Eymeric65/CO2_Portable_sensor_main/PCB/CO2_sensor/Illustration/Front.png

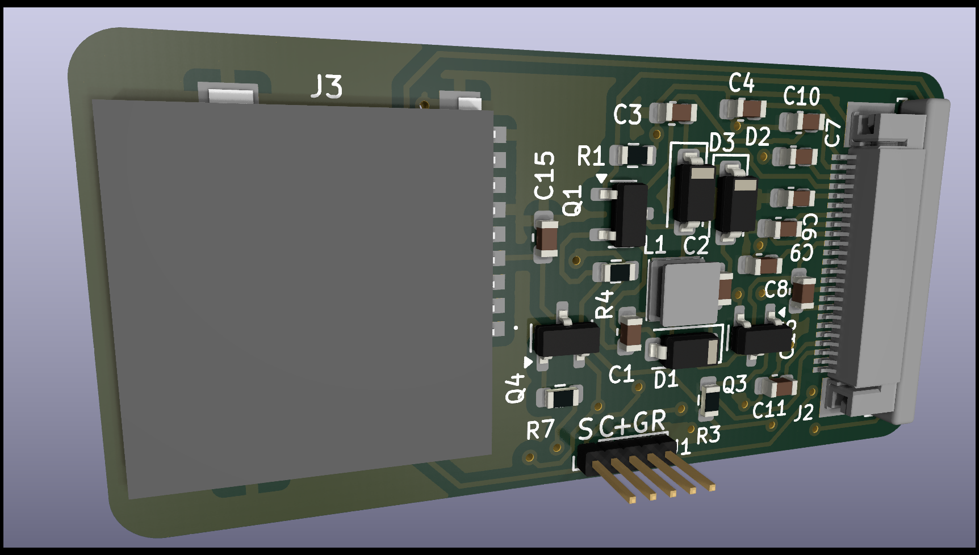
PCB/CO2_sensor/Illustration/Front.png
