Eymeric65/CO2_Portable_sensor_main/PCB/CO2_sensor/Illustration/Back.png

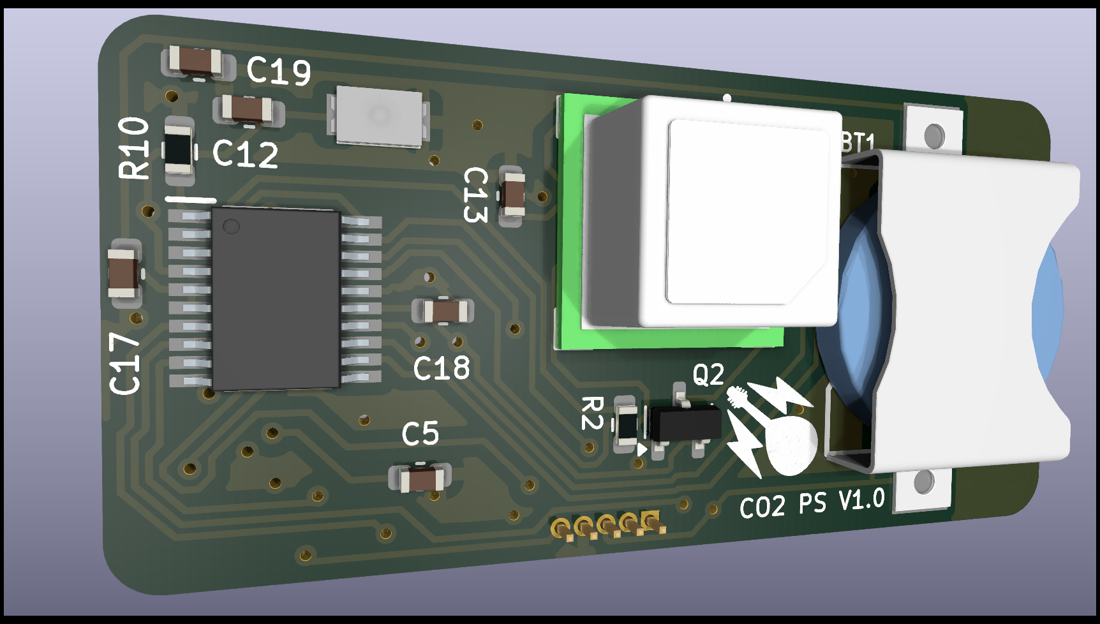
PCB/CO2_sensor/Illustration/Back.png
