Eymeric65/CO2_Portable_sensor_main/PCB/CO2_sensor/Silk/.svg2shenzhen-cache/images/F.SilkS_g2.png

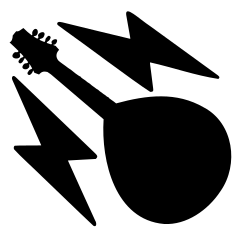
PCB/CO2_sensor/Silk/.svg2shenzhen-cache/images/F.SilkS_g2.png
