Eymeric65/CO2_Portable_sensor_main/case/3D_print/Bottom part.stp

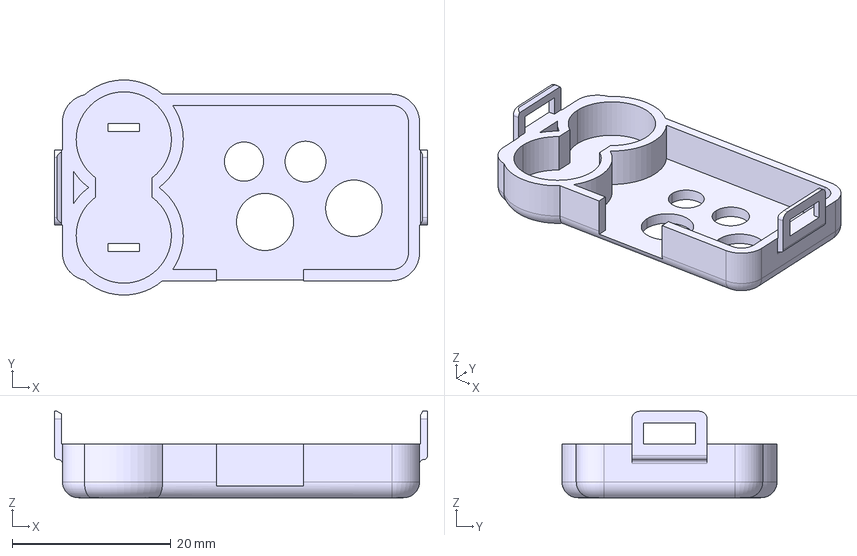
[picture p6: CAD file, 2024-08-28]
case/3D_print/Bottom part.stp
47.0 x 27.1 x 10.9 mm
