Eymeric65/CO2_Portable_sensor_main/case/CO2_sensor.step

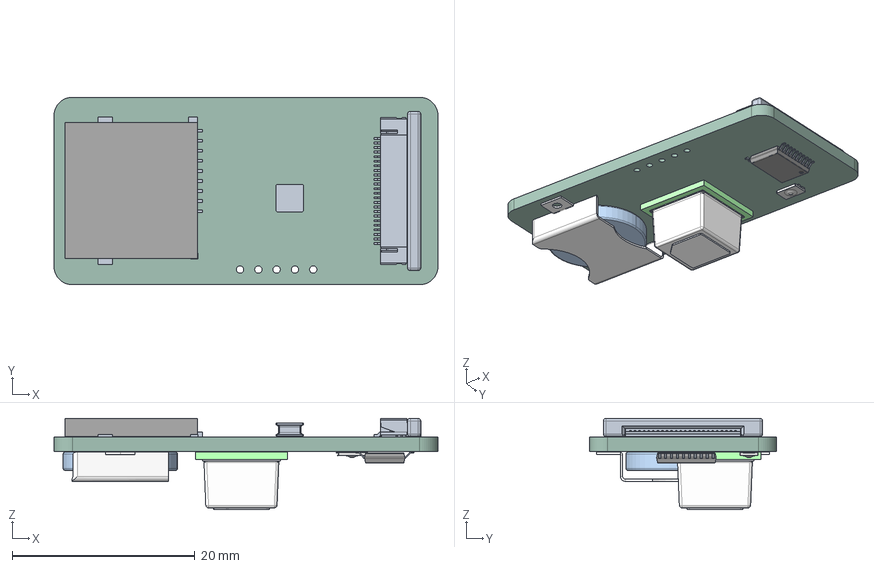
[picture p7: CAD file, 2024-08-28]
case/CO2_sensor.step
42.0 x 20.5 x 10.0 mm
C-2-1734592-4
MSD-1-A
SRN3015
SCD40-D-R2
ASSEMBLY
P:\E-Switch Secure\3D_MODELS_STP_FORMAT\TL3780AFxxxQG.stp
SMTM1225
CO2_sensor_PCB
