Eymeric65/CO2_Portable_sensor_main/PCB/CO2_sensor/STEP/SMTM1225.stp

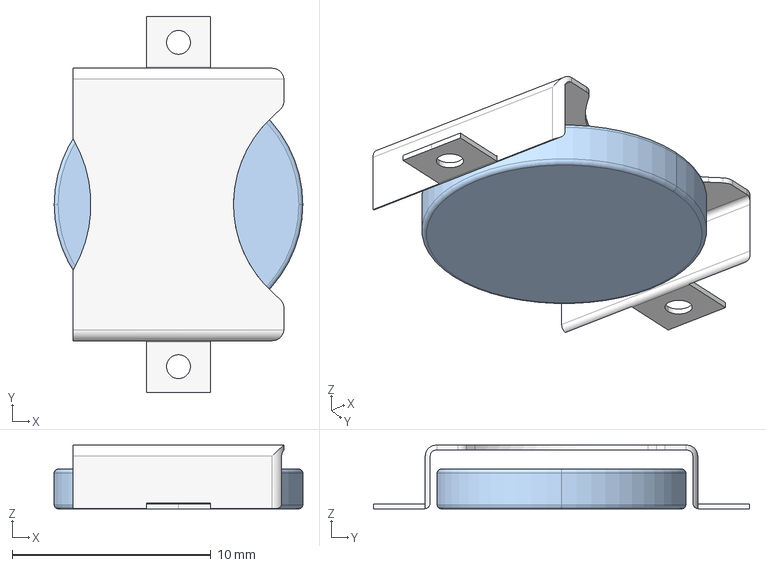
[picture p8: CAD file, 2024-08-28]
PCB/CO2_sensor/STEP/SMTM1225.stp
12.5 x 18.9 x 3.20 mm
Pile
