Eymeric65/CO2_Portable_sensor_main/PCB/Kicad_lib/STEP/FH12-24S-0.5SH.stp

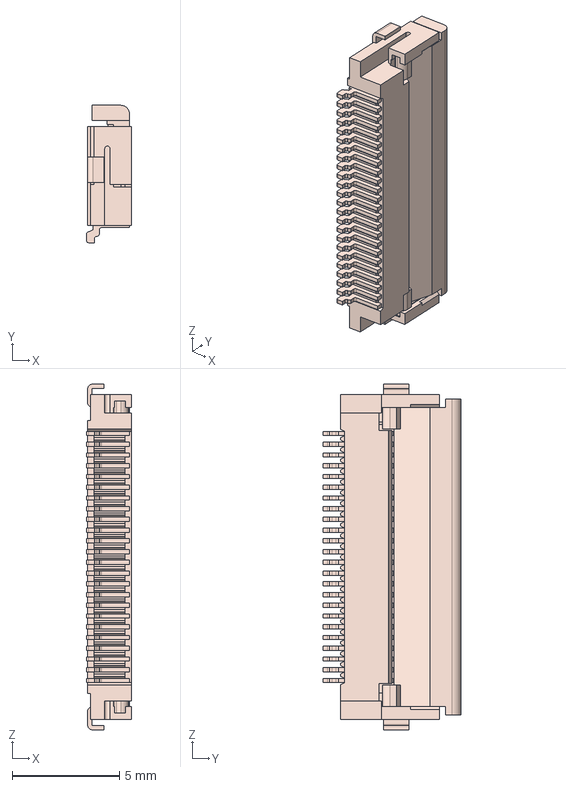
[picture p9: CAD file, 2024-08-28]
PCB/Kicad_lib/STEP/FH12-24S-0.5SH.stp
2.10 x 6.40 x 16.1 mm
