Eymeric65/CO2_Portable_sensor_main/PCB/Kicad_lib/STM32L031F6P7/3D/STM32L031F6P7.stp

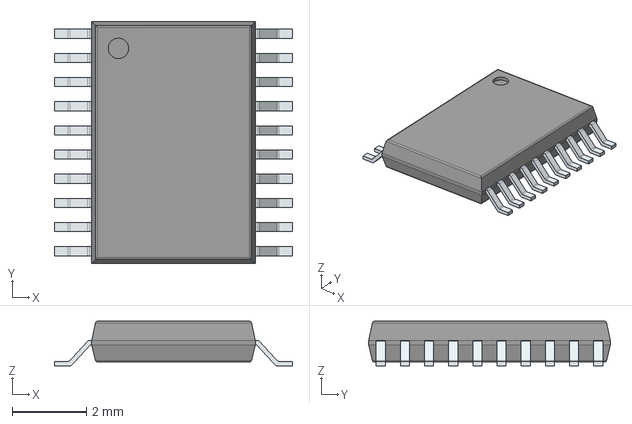
[picture p10: CAD file, 2024-08-28]
PCB/Kicad_lib/STM32L031F6P7/3D/STM32L031F6P7.stp
6.40 x 6.50 x 1.20 mm
PinsArrayLR
