Eymeric65/CO2_Portable_sensor_main/case/3D_print/Top Part.stp

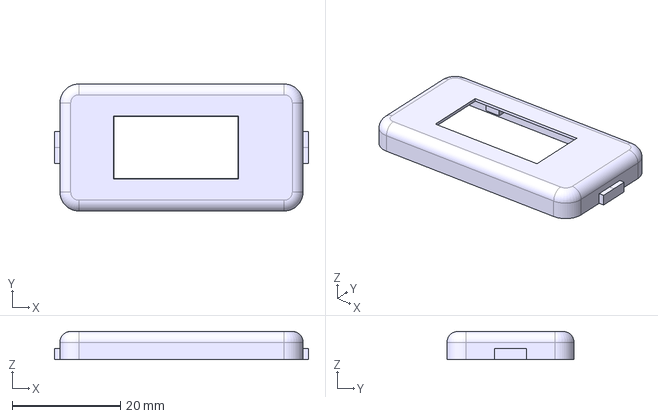
[picture p11: CAD file, 2024-08-28]
case/3D_print/Top Part.stp
47.0 x 23.5 x 5.20 mm
