Eymeric65/CO2_Portable_sensor_main/PCB/Kicad_lib/STEP/TL3780AF240QG.stp

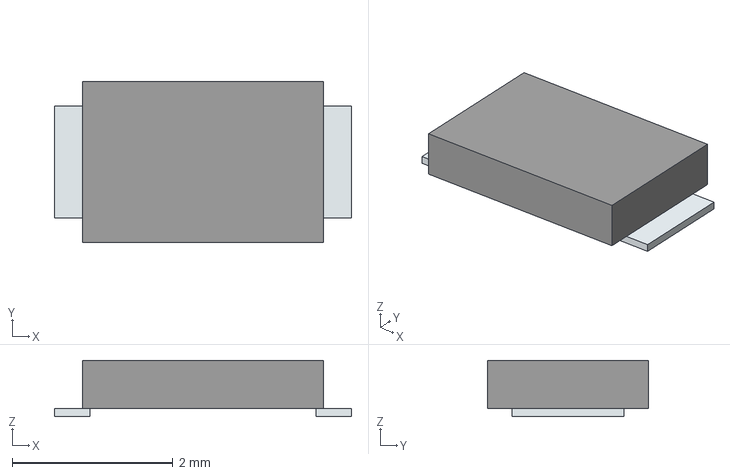
[picture p12: CAD file, 2024-08-28]
PCB/Kicad_lib/STEP/TL3780AF240QG.stp
3.69 x 2.00 x 0.7 mm
Pins
