Eymeric65/CO2_Portable_sensor_main/PCB/STEP manquant/MSD-1-A.stp

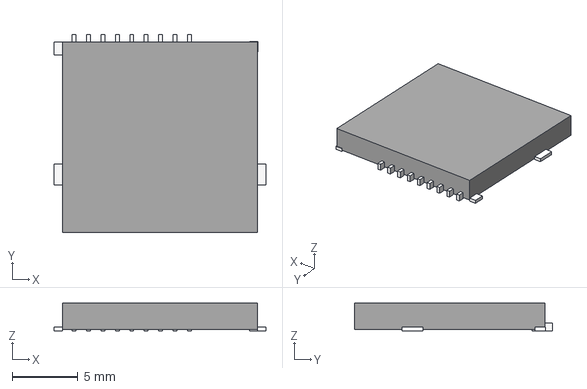
[picture p13: CAD file, 2024-08-28]
PCB/STEP manquant/MSD-1-A.stp
16.1 x 15.1 x 2.10 mm
GND Plate
