Eymeric65/CO2_Portable_sensor_main/PCB/CO2_sensor/STEP/SRN3015-100M.stp

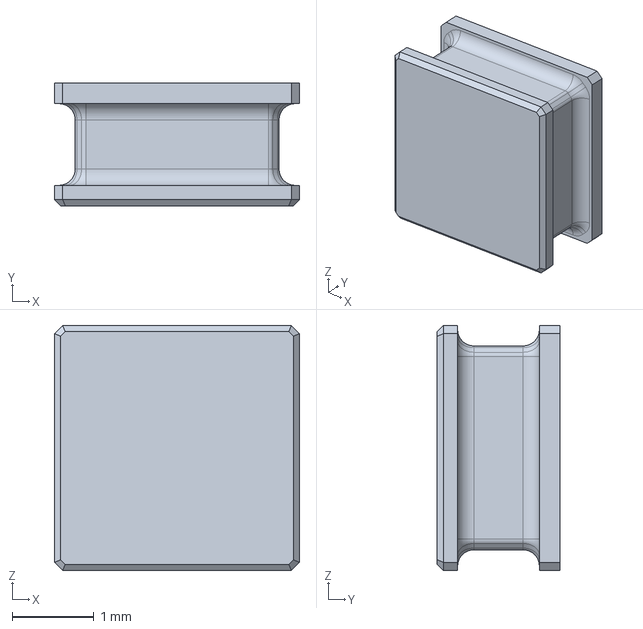
[picture p14: CAD file, 2024-08-28]
PCB/CO2_sensor/STEP/SRN3015-100M.stp
3.00 x 1.50 x 3.00 mm
