Eymeric65/CO2_Portable_sensor_main/PCB/CO2_sensor/STEP/SCD40-D-R2.stp

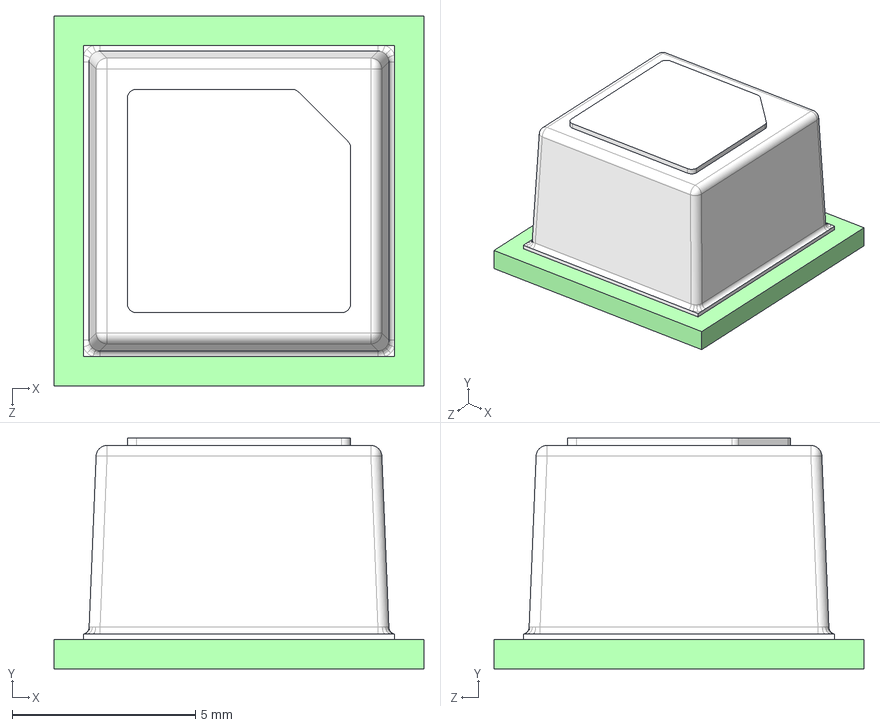
[picture p15: CAD file, 2024-08-28]
PCB/CO2_sensor/STEP/SCD40-D-R2.stp
10.1 x 6.30 x 10.1 mm
