Eymeric65/CO2_Portable_sensor_main/PCB/CO2_sensor/STEP/TL3780AF240QG.stp

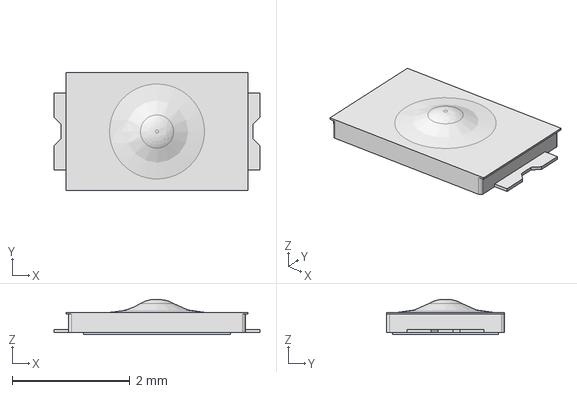
[picture p16: CAD file, 2024-08-28]
PCB/CO2_sensor/STEP/TL3780AF240QG.stp
3.50 x 2.00 x 0.6 mm
