Eymeric65/CO2_Portable_sensor_main/(list of files, cad)

Other CAD files:
PCB/STEP manquant/Body.CATPart
PCB/STEP manquant/GND Plate.CATPart
PCB/STEP manquant/MSD-1-A.CATPart
PCB/STEP manquant/MSD-1-A.CATProduct
PCB/STEP manquant/Pile.CATPart
PCB/STEP manquant/SMTM1225.CATProduct
case/Bottom part.CATPart
case/CO2 probe.CATProduct
case/CO2_sensor PCB.CATPart
case/CO2_sensor.CATProduct
case/COMPOUND.CATPart
case/COMPOUND_1.CATPart
case/LR44.CATPart
case/Part1.CATPart
case/SOLID.CATPart
case/SOLID_1.CATPart
case/SOLID_2.CATPart
case/SOLID_3.CATPart
case/Screen.CATPart
case/Top Part.CATPart
case/Top Part.stp
