Eymeric65/CO2_Portable_sensor_main/PCB/CO2_sensor/CO2_sensor.kicad_pcb

## KiCad design PCB/CO2_sensor/CO2_sensor.kicad_pcb (2024-08-28)

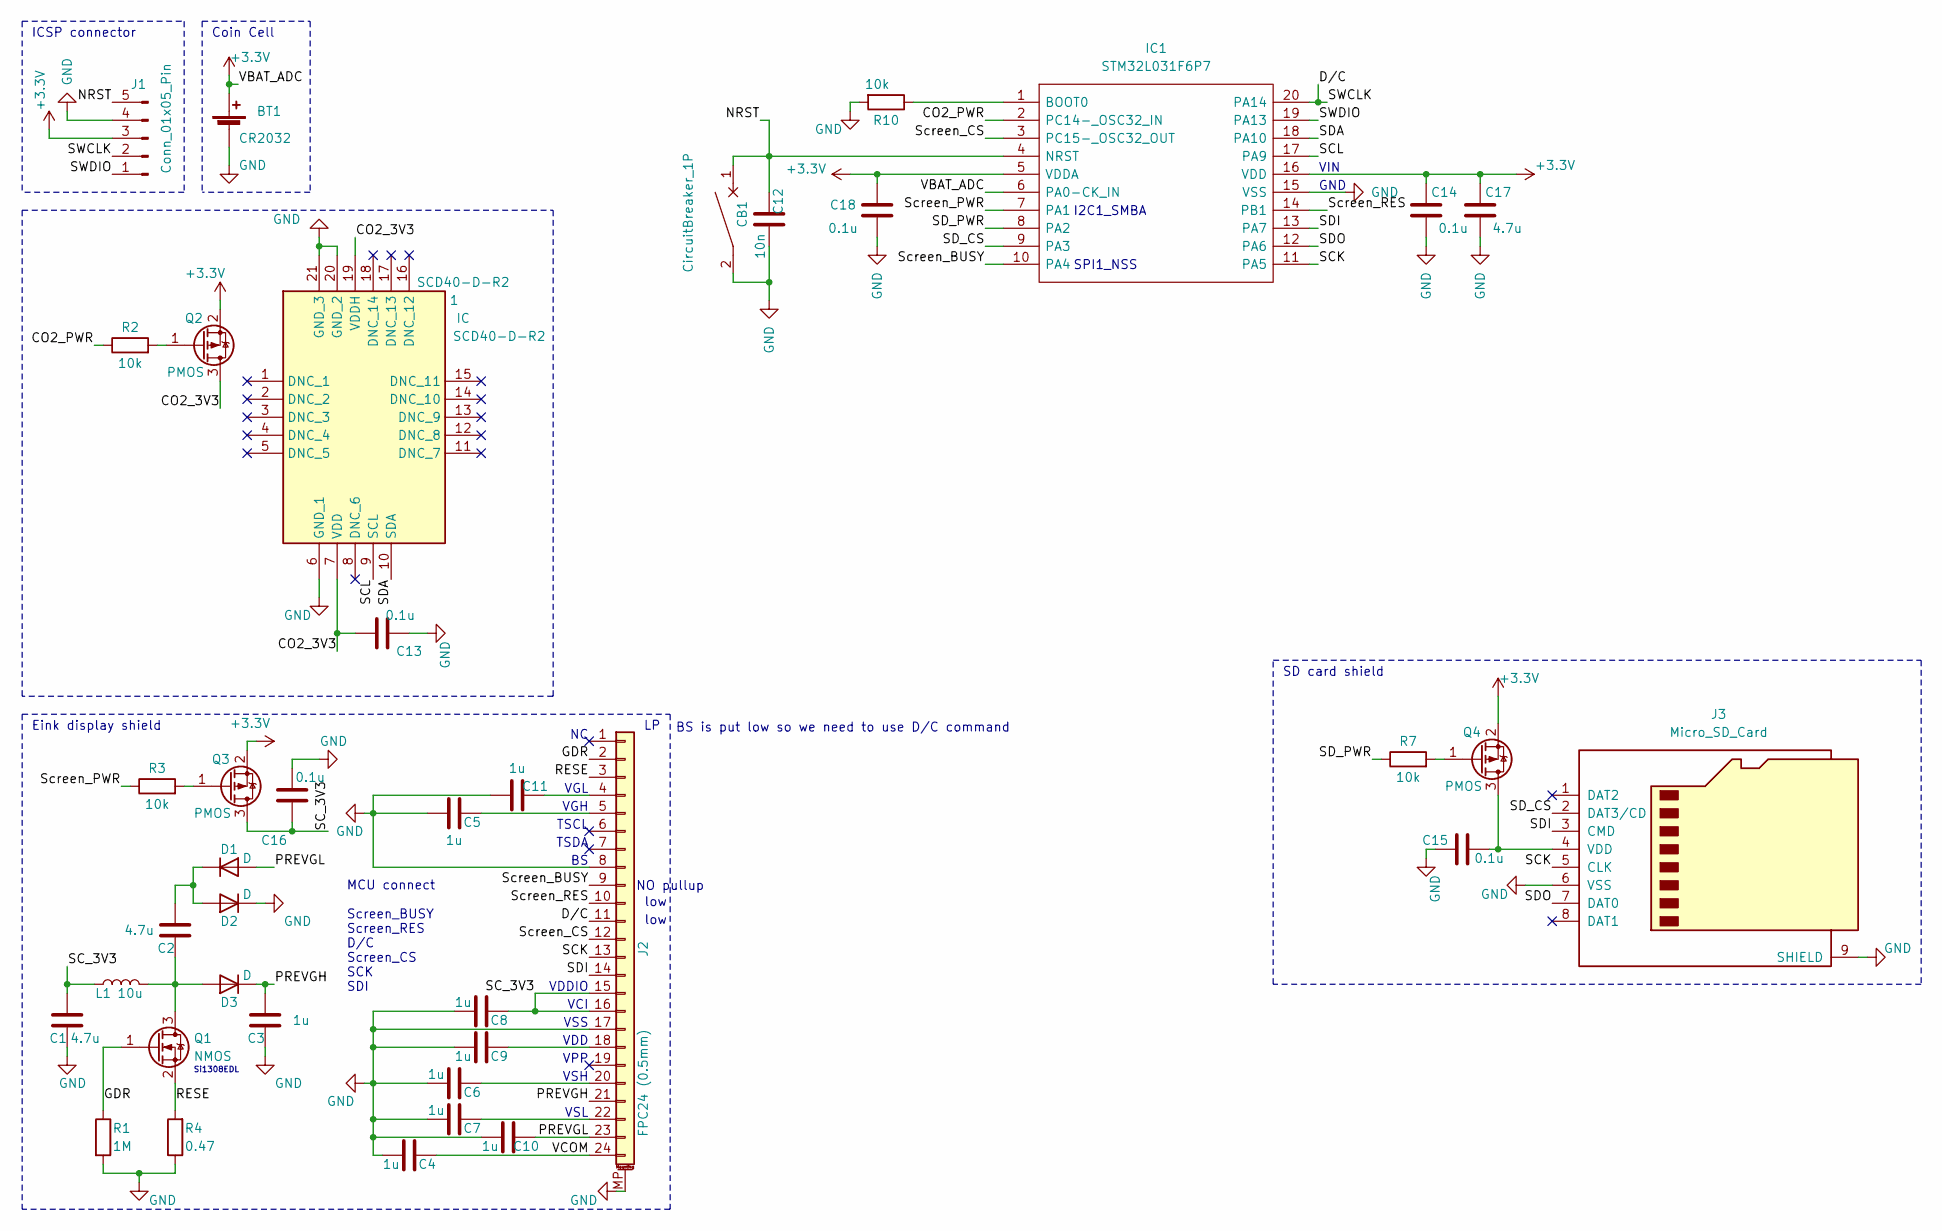
[picture p17: schematic CO2_sensor.kicad_sch]

Parts:
1: SCD40-D-R2; SCD40DR2; Manufacturer_Part_Number SCD40-D-R2; Mouser Part Number 403-SCD40-D-R2
BT1: CR2032; SMTM1225
C1, C2, C17: 4.7u; C_0603_1608Metric
C3, C4, C5, C6, C7, C8, C9, C10, C11: 1u; C_0603_1608Metric
C12: 10n; C_0603_1608Metric
C13, C14, C15, C16, C18: 0.1u; C_0603_1608Metric
CB1: CircuitBreaker_1P; TL3780AF240QG
D1, D2, D3: D; D_SOD-123
IC1: STM32L031F6P7; SOP65P640X120-20N; Mouser Part Number 511-STM32L031F6P7
J1: Conn_01x05_Pin; PinHeader_1x05_P2.00mm_Vertical
J2: FPC24 (0.5mm); TE_2-1734839-4_1x24-1MP_P0.5mm_Horizontal
J3: Micro_SD_Card; MSD1A
L1: 10u; SRN3015
Q1: NMOS; SOT-23
Q2, Q3, Q4: PMOS; SOT-23
R1: 1M; R_0603_1608Metric
R2, R3, R7, R10: 10k; R_0603_1608Metric
R4: 0.47; R_0603_1608Metric

Connections:
+3.3V: BT1.1 (+), C14.2, C17.2, C18.2, IC1.5 (VDDA), IC1.6 (PA0-CK_IN), IC1.16 (VDD), J1.3, Q2.2 (S), Q3.2 (S), Q4.2 (S)
/CO2_3V3: 1.7 (VDD), 1.19 (VDDH), C13.1, Q2.3 (D)
/CO2_PWR: IC1.2 (PC14-_OSC32_IN), R2.1
/D/C: IC1.20 (PA14), J1.2, J2.11
/GDR: J2.2, Q1.1 (G), R1.1
/NRST: C12.2, CB1.1, IC1.4 (NRST), J1.5
/PREVGH: C3.1, D3.1 (K), J2.21
/PREVGL: C10.2, D1.2 (A), J2.23
/RESE: J2.3, Q1.2 (S), R4.2
/SCK: IC1.11 (PA5), J2.13, J3.5 (CLK)
/SCL: 1.9 (SCL), IC1.17 (PA9)
/SC_3V3: C1.1, C8.2, C16.2, J2.15, J2.16, L1.1, Q3.3 (D)
/SDA: 1.10 (SDA), IC1.18 (PA10)
/SDI: IC1.13 (PA7), J2.14, J3.3 (CMD)
/SDO: IC1.12 (PA6), J3.7 (DAT0)
/SD_CS: IC1.9 (PA3), J3.2 (DAT3/CD)
/SD_PWR: IC1.8 (PA2), R7.1
/SWDIO: IC1.19 (PA13), J1.1
/Screen_BUSY: IC1.10 (PA4), J2.9
/Screen_CS: IC1.3 (PC15-_OSC32_OUT), J2.12
/Screen_PWR: IC1.7 (PA1), R3.1
/Screen_RES: IC1.14 (PB1), J2.10
/VCOM: C4.2, J2.24
GND: 1.6 (GND_1), 1.20 (GND_2), 1.21 (GND_3), BT1.2 (-), C1.2, C3.2, C4.1, C5.1, C6.1, C7.1, C8.1, C9.1, C10.1, C11.1, C12.1, C13.2, C14.1, C15.2, C16.1, C17.1, C18.1, CB1.2, D2.1 (K), IC1.15 (VSS), J1.4, J2.8, J2.17, J2.MP (MountPin), J3.6 (VSS), J3.9 (SHIELD), R1.2, R4.1, R10.2
unnamed: C2.1, D1.1 (K), D2.2 (A)
unnamed: C2.2, D3.2 (A), L1.2, Q1.3 (D)
unnamed: IC1.1 (BOOT0), R10.1
unnamed: C11.2, J2.4
unnamed: C5.2, J2.5
unnamed: C9.2, J2.18
unnamed: C6.2, J2.20
unnamed: C7.2, J2.22
unnamed: C15.1, J3.4 (VDD), Q4.3 (D)
unnamed: Q2.1 (G), R2.2
unnamed: Q3.1 (G), R3.2
unnamed: Q4.1 (G), R7.2

Notes on the sheet:
SD card shield
Si1308EDL
ICSP connector
VGH
SPI1_NSS
VSS
TSDA
VDD
BS is put low so we need to use D/C command
NO pullup
MCU connect Screen_BUSY Screen_RES D/C Screen_CS SCK SDI
TSCL
VPP
VIN
GND
low
VDDIO
VGL
Coin Cell
VCI
Eink display shield
VSH
I2C1_SMBA
VSL

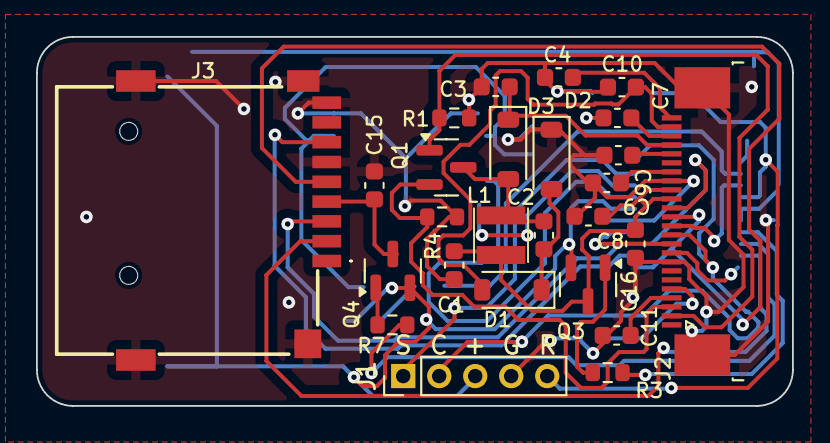
[picture p18: board CO2_sensor.kicad_pcb from above]

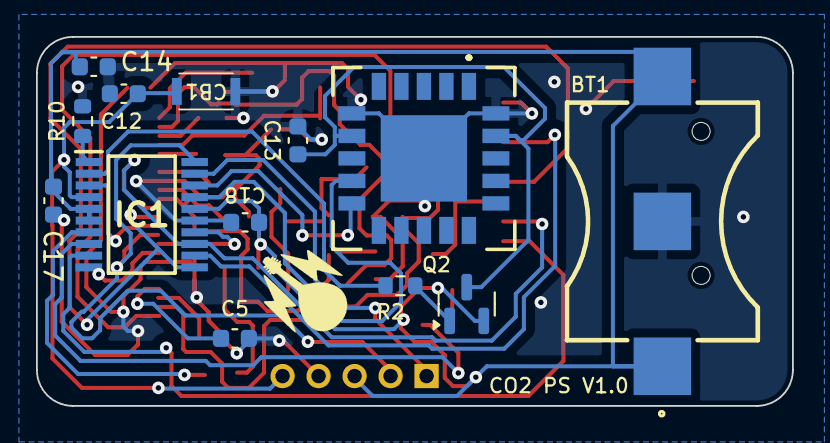
[picture p19: board CO2_sensor.kicad_pcb from below]

Board: 2 copper layers, 42.0 x 20.5 mm, 40 parts (14 on the bottom side), 36 nets.

Other parts of the board:
Ref**: Val**; drawing
