Eymeric65/CO2_Portable_sensor_main/Sonde_CO2/Core/Src/main.c

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
/* Includes ------------------------------------------------------------------*/
#include "main.h"

I2C_HandleTypeDef hi2c1;

RTC_HandleTypeDef hrtc;

SPI_HandleTypeDef hspi1;

void SystemClock_Config(void);
static void MX_GPIO_Init(void);
static void MX_I2C1_Init(void);
static void MX_SPI1_Init(void);
static void MX_RTC_Init(void);
/**
  * @brief  The application entry point.
  * @retval int
  */
int main(void)
{

  /* MCU Configuration--------------------------------------------------------*/

  /* Reset of all peripherals, Initializes the Flash interface and the Systick. */
  HAL_Init();

  /* Configure the system clock */
  SystemClock_Config();

  /* Initialize all configured peripherals */
  MX_GPIO_Init();
  MX_I2C1_Init();
  MX_SPI1_Init();
  MX_RTC_Init();
  /* USER CODE BEGIN 2 */
  SCREEN_GPIO_Deact();

  uint8_t DrawMap[EPD_ARRAY];

  //memset(DrawMap,0xFF,sizeof(DrawMap));
  memcpy(DrawMap,Base_map,sizeof(Base_map));

  //HAL_GPIO_WritePin(GPIOC, CO2_PWR_Pin, GPIO_PIN_SET);


    SCREEN_GPIO_Act();

    HAL_Delay(1000);

	EPD_Init(); //Full screen refresh initialization.
	EPD_WhiteScreen_ALL(DrawMap); //To Display one image using full screen refresh.
	EPD_DeepSleep(); //Enter the sleep mode and please do not delete it, otherwise it will reduce the lifespan of the screen.

	SCREEN_GPIO_Deact();

	HAL_Delay(1000);

  /* USER CODE END 2 */

  /* Infinite loop */
  /* USER CODE BEGIN WHILE */
	unsigned int t = 0;

  while (1)
  {

		//UNCOMMENT THIS

		uint8_t response[9];
		HAL_GPIO_WritePin(GPIOC, CO2_PWR_Pin, GPIO_PIN_RESET); // pin power
		HAL_Delay(100);

		while(Send_I2C_Command(&hi2c1, SCD_ADDRESS, (uint16_t ) 0x21b1, 20)!= HAL_OK){HAL_Delay(50);};

		HAL_StatusTypeDef ans1 = HAL_ERROR;

		while( ans1 == HAL_ERROR)
		{
			Send_I2C_Command(&hi2c1, SCD_ADDRESS, (uint16_t ) 0xec05, 20);

			HAL_Delay(1);

			ans1 = HAL_I2C_Master_Receive(&hi2c1,SCD_ADDRESS, (uint8_t *) response,9, 20);
			HAL_Delay(50);
		}

		Send_I2C_Command(&hi2c1, SCD_ADDRESS, (uint16_t ) 0x3f86, 20);

		HAL_GPIO_WritePin(GPIOC, CO2_PWR_Pin, GPIO_PIN_SET); // pin power
//		//
//		//
//		//
//		//
		uint16_t CO2 = (response[0] << 8) | response[1];

		float T =  (response[3] << 8) | response[4];

		T = -45 + 175*T/65536;

		float H =  (response[6] << 8) | response[7];

		H = 100*H/65536;

		SCREEN_GPIO_Act();

		HAL_Delay(250);

		t = t+2;

		Display_Text(Zone_Write_nums(64,17,FONT_INFO,(int) T,0,0,4),DrawMap,Base_map );
		Display_Text(Zone_Write_nums(34,65,FONT_CO2,CO2,0,1,5),DrawMap,Base_map);
		Display_Text(Zone_Write_nums(20,17,FONT_INFO,(int) H,0,0,4),DrawMap,Base_map );

		Display_Text(Zone_Write_nums(118,83,FONT_TIME,t/60,0,0,5),DrawMap,Base_map ); //Heure
		Display_Text(Zone_Write_nums(81,83,FONT_TIME,t%60,0,0,2),DrawMap,Base_map ); //Minutes

		EPD_DeepSleep();
//
//


//
//		//--------------------------------------
//
	  HAL_GPIO_WritePin(GPIOC, CO2_PWR_Pin, GPIO_PIN_SET);
	  SCREEN_GPIO_Deact();

		HAL_SuspendTick();
		HAL_RTCEx_SetWakeUpTimer_IT(&hrtc, 600, RTC_WAKEUPCLOCK_CK_SPRE_16BITS);

		/* Enter STOP 2 mode */
		HAL_PWR_EnterSTOPMode(PWR_LOWPOWERREGULATOR_ON,  PWR_STOPENTRY_WFI);
		//HAL_PWR_EnterSTOPMode(PWR_MAINREGULATOR_ON,  PWR_STOPENTRY_WFI);


		//HAL_PWREx_EnterSTOP2Mode(PWR_STOPENTRY_WFI);
		HAL_RTCEx_DeactivateWakeUpTimer(&hrtc);
		SystemClock_Config();
		HAL_ResumeTick();


    /* USER CODE END WHILE */

    /* USER CODE BEGIN 3 */
  }
  /* USER CODE END 3 */
}

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
