Eymeric65/CO2_Portable_sensor_main/Sonde_CO2/Sonde_CO2.ioc

Mcu.UserName=STM32L031F6Px
PA1.GPIO_Label=Screen_PWR
PA1.Signal=GPIO_Output
PA10.Signal=I2C1_SDA
PA14.GPIO_Label=D_C
PA14.Signal=GPIO_Output
PA2.GPIO_Label=SD_PWR
PA2.Signal=GPIO_Output
PA3.GPIO_Label=SD_CS
PA3.Signal=GPIO_Output
PA4.GPIO_Label=Screen_Busy
PA4.Signal=GPIO_Input
PA5.Signal=SPI1_SCK
PA6.Signal=SPI1_MISO
PA7.Signal=SPI1_MOSI
PA9.Signal=I2C1_SCL
PB1.GPIO_Label=Screen_Res
PB1.Signal=GPIO_Output
PC14-OSC32_IN.GPIO_Label=CO2_PWR
PC14-OSC32_IN.Signal=GPIO_Output
PC15-OSC32_OUT.GPIO_Label=Screen_CS
PC15-OSC32_OUT.Signal=GPIO_Output
