Eymeric65/CO2_Portable_sensor_main/(notices)

Notices in the files:
Sonde_CO2/Core/Src/main.c:
Copyright (c) 2024 STMicroelectronics.
All rights reserved.
This software is licensed under terms that can be found in the LICENSE file
